westonnovelli/project-actuator/docs/assets/android-chrome-144x144.png

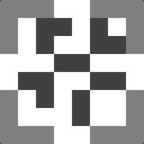
docs/assets/android-chrome-144x144.png
