westonnovelli/project-actuator/images/above-monitor.jpg

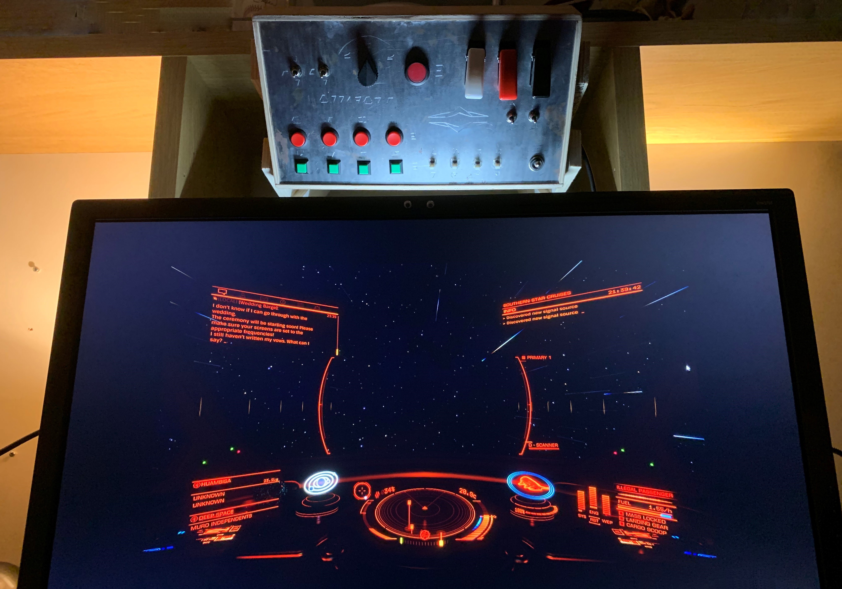
images/above-monitor.jpg
