westonnovelli/project-actuator/images/wiring-diagram-clear.png

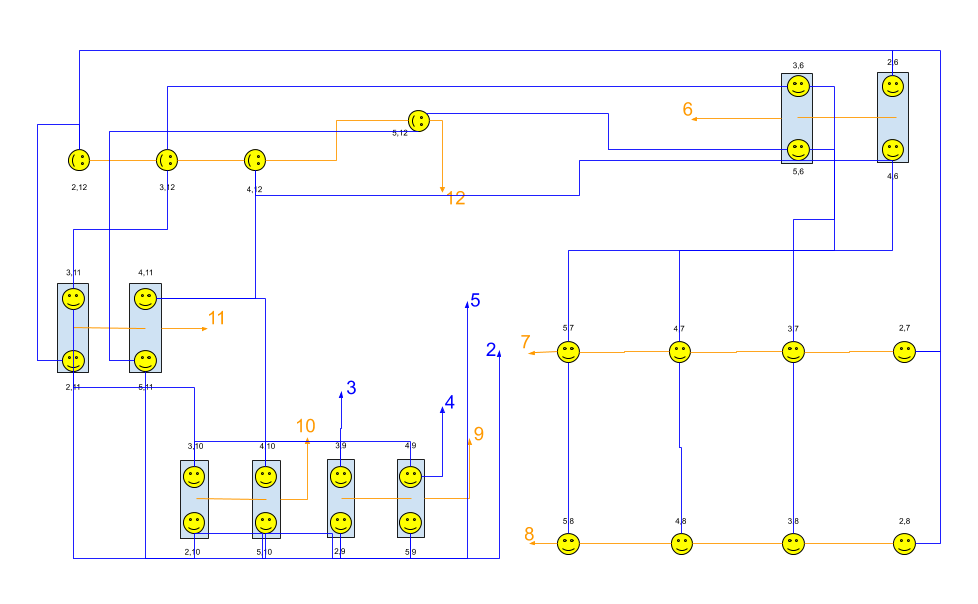
images/wiring-diagram-clear.png
